HITSZ-OpenAuto/AUTO3016/labs/README.md

# 说明

实验报告

本报告仅作学习交流、数据检验与分析参考，请在自主完成实验后酌量食用，切忌照搬照抄。
