HITSZ-OpenAuto/AUTO3016/labs/2023/LJH/README.md

# 说明

本报告仅作学习交流、数据检验与分析参考，请在自主完成实验后酌量食用，切忌照搬照抄。 

本报告实验数据均通过课上检验，误差处于合理范围内。现象分析与思考题不保证完全正确。 

本报告依照 21 级实验报告要求撰写，若下届部分问题存在差异，属正常现象。

自控实践课每年制作内容差别不大，但报告要求会有不同。
本组焊接全部采用【飞线】方式，可能存在一定技术难度。
