HITSZ-OpenAuto/AUTO3016/(list of files, drawings)

Other design files:
labs/2024/psp/simu/encoder_quadrature_circuit.ms14
labs/2024/psp/simu/L298.pdsprj
