HITSZ-OpenAuto/AUTO3016/(commit log)

2024-01-05 新添加一个版本的报告
2024-09-23 更新课程名和文档 (#9)
2024-11-17 更新报告2
2025-01-13 添加新报告 (#12)
    [L298.pdsprj, encoder_quadrature_circuit.ms14]
2025-01-18 更新2022实验报告版本；更新 README (#13)
    * 更新2022实验报告版本；更新 README
    * rename
    [机械特性.xlsx]
2025-01-22 删除仓库文件夹中无意义的 README.md，以 .gitkeep 占位
